neubertphillip-commits/fx991/hardware/tastatur_nummern.jpg

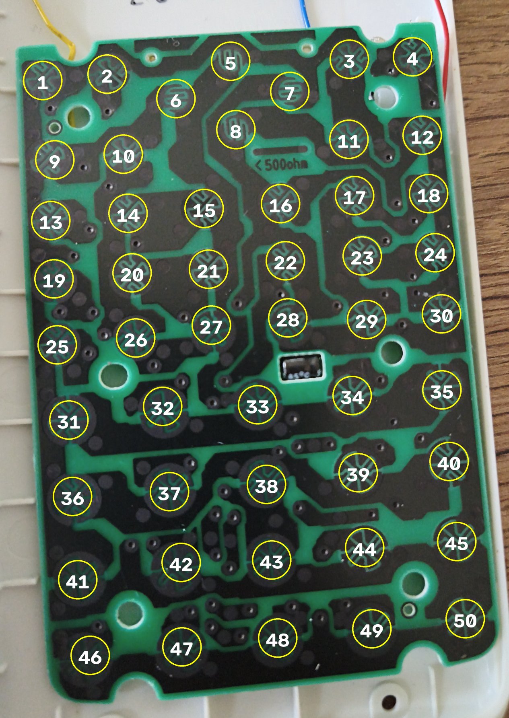
hardware/tastatur_nummern.jpg
