neubertphillip-commits/fx991/hardware/loetpunkte.jpg

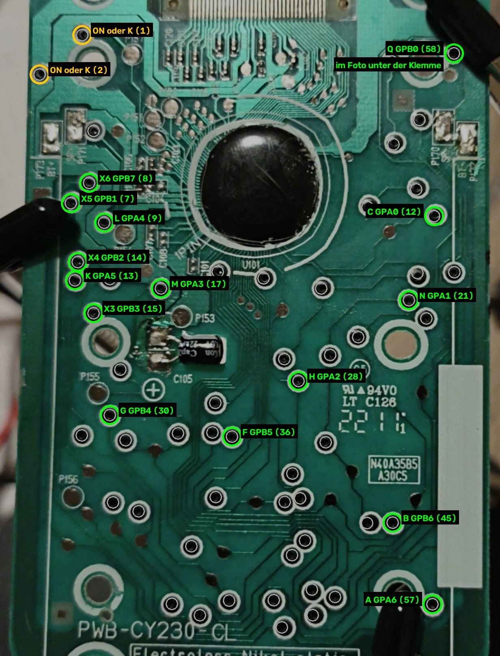
hardware/loetpunkte.jpg
