neubertphillip-commits/fx991/hardware/pcb/vorlage.pdf

1

2

3

4

5

6 | 7

8

9 | 10 | 11 | 12
13 | 14 | 15 | 16 | 17 | 18
19 | 20 | 21 | 22 | 23 | 24
25 | 26 | 27 | 28 | 29 | 30
31 | 32 | 33 | 34 | 35
36 | 37 | 38 | 39 | 40
41 | 42 | 43 | 44 | 45
46 | 47 | 48 | 49 | 50

50 mm - nachmessen! Drucken mit 100 % / tatsaechlicher Groesse

10 x 10 mm

# Casio-Deck Tastaturplatine - Papiertest (Entwurf 1)

Tastenseite von vorn. Blau: gemessen, rot gestrichelt: geschaetzt (im Foto im Schatten). Genauigkeit ca. 0,5-1 mm.

Loecher bewusst vergroessert (Spiel fuer die Zapfen, Platine wird festgeklebt). Wichtig ist nur: Tasten zueinander. Test: Matte auflegen, so schieben, dass die Noppen mittig sitzen. Abweichungen notieren (z. B. '46: 1 mm rechts').
