neubertphillip-commits/fx991/hardware/gegenmessung.md

# Gegenmessung: gehoeren Leitungen noch zusammen?

Zwei Leitungen koennen nur eine sein, wenn dadurch keine zwei Tasten dieselben zwei Leitungen
bekaemen (Beispiel: F und G nicht, sonst waeren 4 (C-F) und 7 (C-G) gleich). Nach dieser Regel
bleiben nur vier Paare, alle mit K.

2k-Bereich. **Nur kleine Werte (~0.05-0.60) zaehlen**, hohe Werte sind Umwege ueber den Casio-Chip.

| Messung | Kontakte | Ergebnis |
|---|---|---|
| K ↔ B | 18 (K-Haelfte) ↔ 42 (B-Haelfte) | getrennt |
| K ↔ F | 18 (K-Haelfte) ↔ 37 (F-Haelfte) | getrennt |
| K ↔ G | 18 (K-Haelfte) ↔ 32 (G-Haelfte) | getrennt |
| K ↔ Q | 18 (K-Haelfte) ↔ 5 (Q-Haelfte) | getrennt |
| 4 ↔ Q | 4 (EB-Haelfte, nicht K) ↔ 5 (Q-Haelfte) | getrennt: 4 hat eine eigene Leitung |

Gemessen: A und B mit keiner anderen Leitung verbunden. F-G gemessen, kann aber nicht sein
(siehe oben): bei 32 und 37 die N-Haelften getroffen (beide an N).
