neubertphillip-commits/fx991/hardware/pcb/vorlage.png

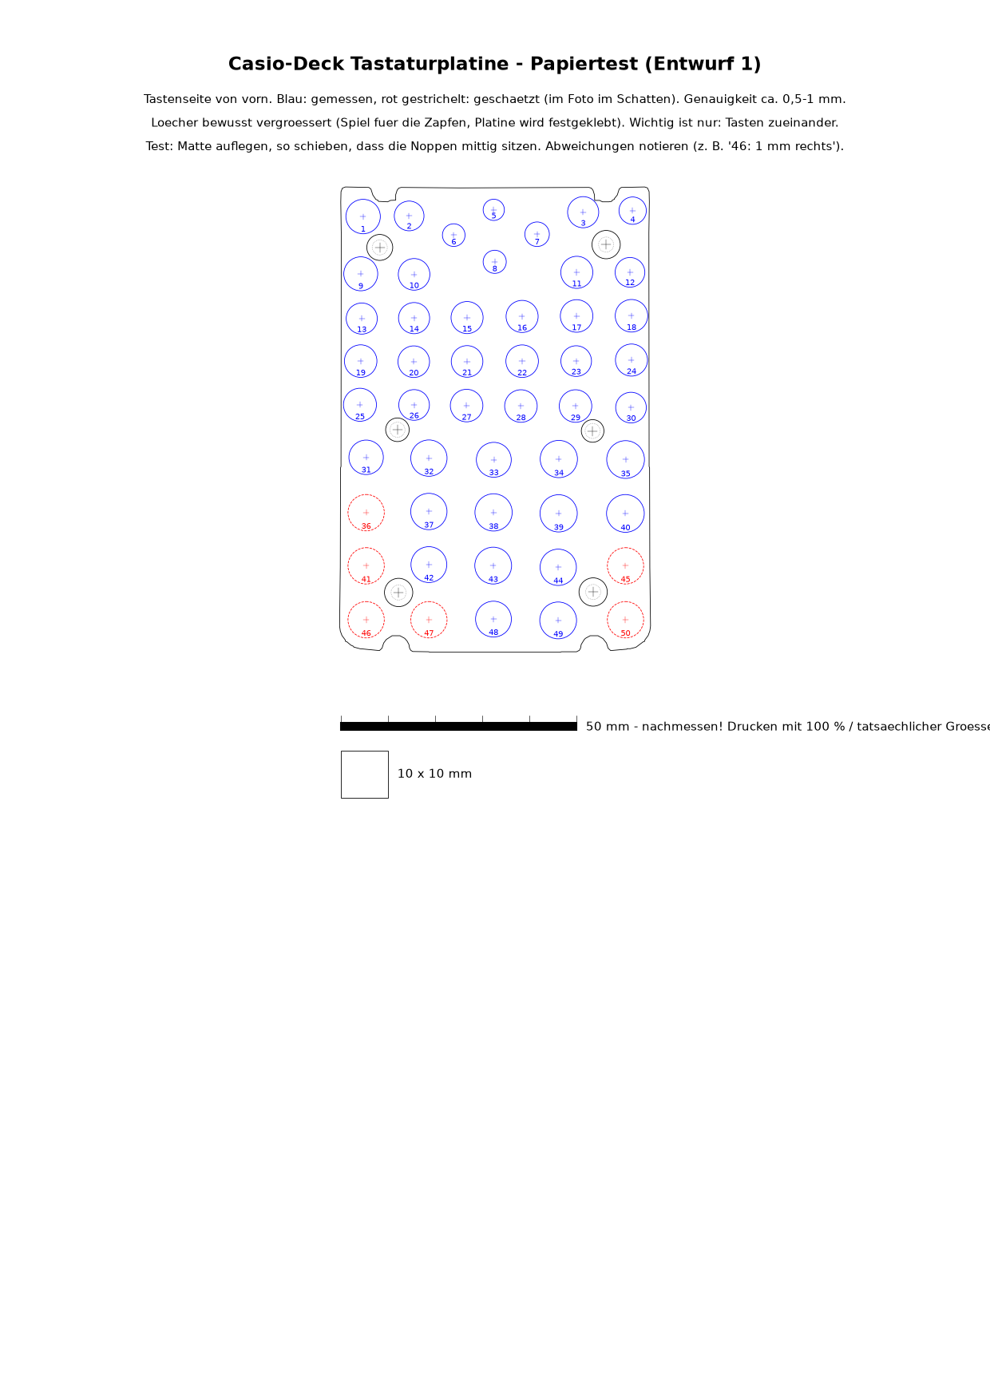
hardware/pcb/vorlage.png
