neubertphillip-commits/fx991/hardware/pcb/vorschau.png

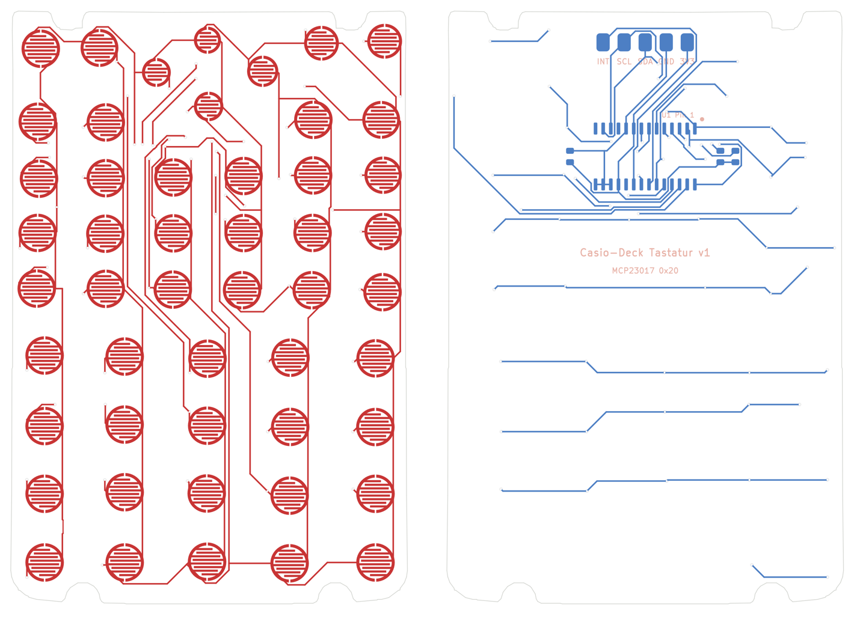
hardware/pcb/vorschau.png
