neubertphillip-commits/fx991/hardware/rueckseite_punkte.jpg

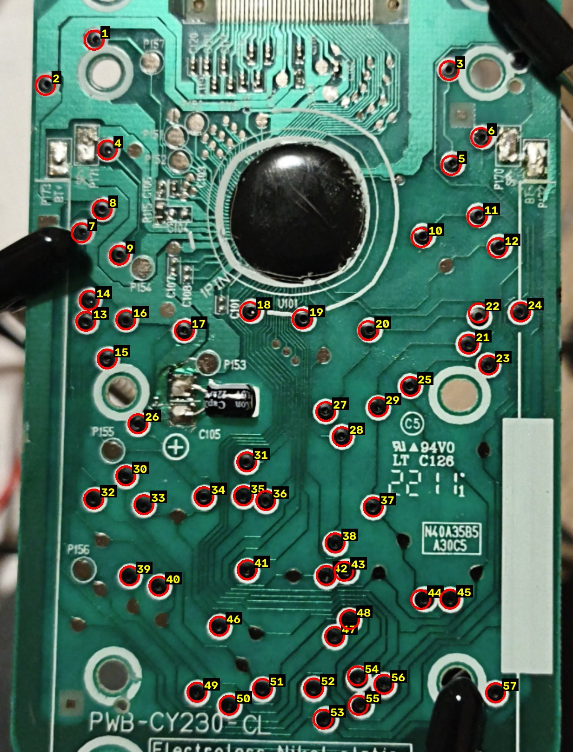
hardware/rueckseite_punkte.jpg
