neubertphillip-commits/fx991/(list of files, drawings)

Other design files:
hardware/pcb/tastatur.dsn
