neubertphillip-commits/fx991/hardware/pcb/tastatur.kicad_pcb

## KiCad design hardware/pcb/tastatur.kicad_pcb (2026-09-30)

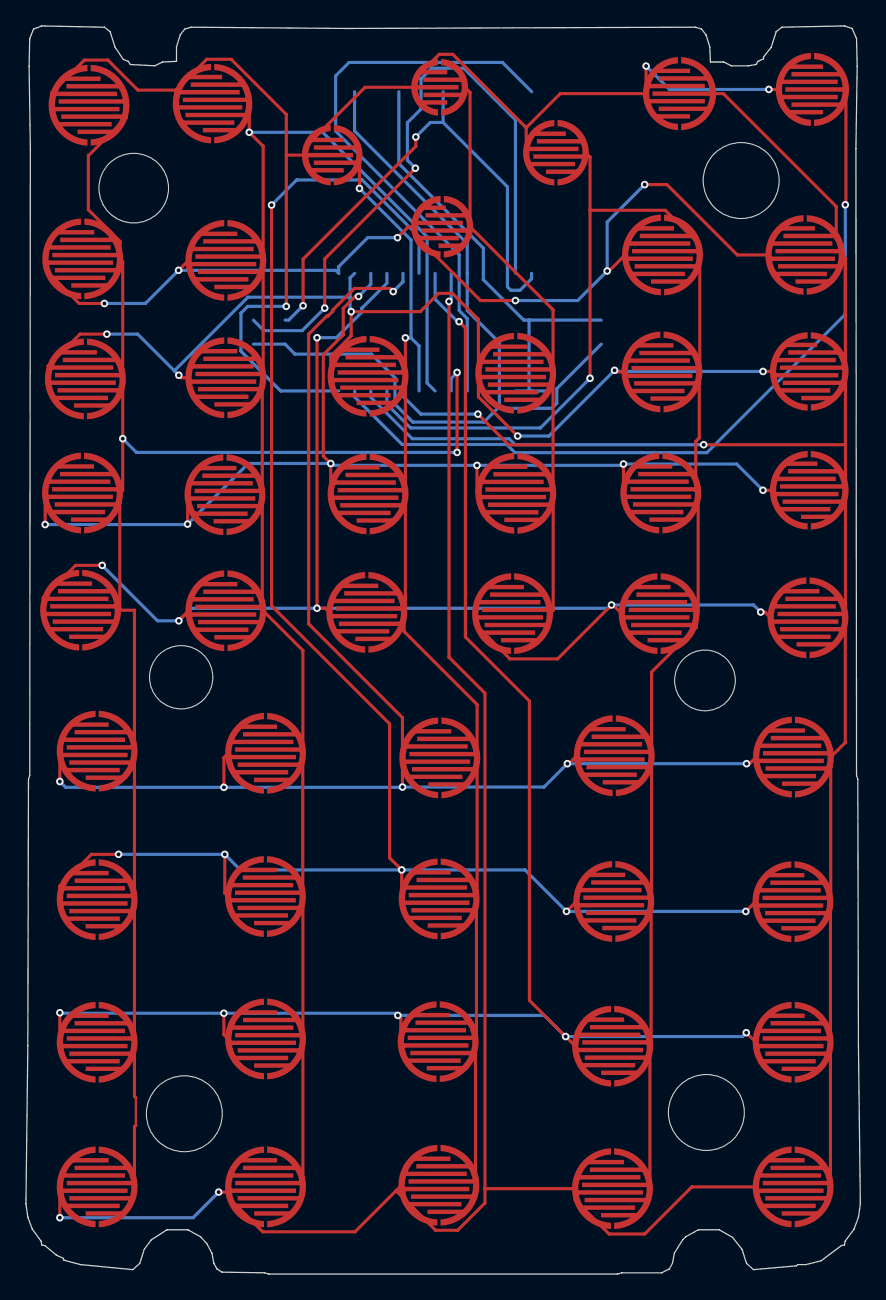
[picture p6: board tastatur.kicad_pcb from above]

Board: 2 copper layers, 65.9 x 98.6 mm, 61 parts (0 on the bottom side), 21 nets.

Parts:
C1: 100nF
H1, H2, H3, H4, H5, H6: (no value)
J1: XIAO
K1, K2, K3, K4, K5, K6, K7, K8, K9, K10, K11, K12, K13, K14, K15, K16, K17, K18, K19, K20, K21, K22, K23, K24, K25, K26, K27, K28, K29, K30, K31, K32, K33, K34, K35, K36, K37, K38, K39, K40, K41, K42, K43, K44, K45, K46, K47, K48, K49, K50: Taste
R1, R2: 4.7k
U1: MCP23017-E/SO

Connections:
3V3: C1.1, J1.1, R1.1, R2.1, U1.9, U1.18
C0: K1.2, K9.2, K13.2, K19.2, K25.2, K31.2, K36.2, K41.2, K46.2, U1.21
C1: K2.2, K10.2, K14.2, K20.2, K26.2, K32.2, K37.2, K42.2, K47.2, U1.22
C2: K6.2, K15.2, K21.2, K27.2, K33.2, K38.2, K43.2, K48.2, U1.23
C3: K5.2, K8.2, K16.2, K22.2, K28.2, U1.24
C4: K7.2, K11.2, K17.2, K23.2, K29.2, K34.2, K39.2, K44.2, K49.2, U1.25
C5: K3.2, K12.2, K18.2, K24.2, K30.2, K35.2, K40.2, K45.2, K50.2, U1.26
C6: K4.2, U1.27
GND: C1.2, J1.2, U1.10, U1.15, U1.16, U1.17
INT: J1.5, U1.20
R0: K1.1, K2.1, K3.1, K4.1, K5.1, K6.1, K7.1, U1.28
R1: K8.1, K9.1, K10.1, K11.1, K12.1, U1.1
R2: K13.1, K14.1, K15.1, K16.1, K17.1, K18.1, U1.2
R3: K19.1, K20.1, K21.1, K22.1, K23.1, K24.1, U1.3
R4: K25.1, K26.1, K27.1, K28.1, K29.1, K30.1, U1.4
R5: K31.1, K32.1, K33.1, K34.1, K35.1, U1.5
R6: K36.1, K37.1, K38.1, K39.1, K40.1, U1.6
R7: K41.1, K42.1, K43.1, K44.1, K45.1, U1.7
R8: K46.1, K47.1, K48.1, K49.1, K50.1, U1.8
SCL: J1.4, R2.2, U1.12
SDA: J1.3, R1.2, U1.13
