neubertphillip-commits/fx991/firmware/casio_deck/casio_deck.ino

// Casio-Deck: XIAO ESP32S3 im Gehaeuse eines Casio fx-991.
// Die eigentliche Logik steckt in app.cpp; siehe firmware/README.md.

#include "app.h"

void setup() { app::begin(); }

void loop() { app::loop(); }
