neubertphillip-commits/fx991/(commit log)

2026-09-25 Bridge fuer Termux und Projektkontext
    Claude-Session: https://claude.ai/code/session_01WamsmbzaYvenZsV1E42j99
2026-09-25 Firmware-Grundgeruest fuer den XIAO ESP32S3
    Zustandsautomat (Rechner / Terminal / Kamera), WLAN mit automatischer
    Abschaltung im Rechnermodus, WebSocket-Client fuer das Bridge-Protokoll
    und MCP23017-Tastaturscan mit Entprellung und INTA-Wakeup. Solange das
    LT7680-Panel fehlt, wird der Bildschirm auf dem seriellen Monitor
    ausgegeben; Eingaben gehen dort ebenfalls. Unbelegte Tasten melden
    Zeile/Spalte und MCP-Pin, um die Matrix auszumessen.
    Kompiliert mit arduino-esp32 3.3.12 (XIAO_ESP32S3, OPI-PSRAM);
    Host-Tests fuer Rechner und Textpuffer unter firmware/hosttest.
    Claude-Session: https://claude.ai/code/session_018xurYUYAMjcQd5yu9g7cvN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
2026-09-25 ALPHA-Texteingabe, Kamera und PC-Simulator
    - Mehrfachtippen wie am alten Handy (inkl. Umlaute/ss), ALPHA je Modus,
    im Terminal und Kameramodus standardmaessig an
    - Kamera (OV3660, XIAO-Sense-Pins): an nur im Kameramodus, EXE schickt
    JPEG als Binaer-Frame und die Eingabe als Frage an die Bridge
    - PC-Simulator (firmware/sim): dieselbe Firmware-Logik als Terminal-
    programm mit Arduino/WiFi/WebSocket-Ersatz, spricht mit der echten
    Bridge; zeichnet den 60x40-Screen als Vorlage fuers Panel-Layout
    - net::setBridge(), app::injectKey(), serieller Befehl ":key NAME"
    - Host-Tests fuer Mehrfachtippen
    Firmware kompiliert mit arduino-esp32 3.3.12; Simulator end-to-end
    gegen bridge.py mit Fake-cla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
2026-09-26 Spracheingabe ueber das Mikrofon der Sense-Platine
    - Firmware: PDM-Aufnahme (ESP_I2S) in eigenem Task in den PSRAM,
    max. 30 s, als WAV (16 kHz mono) per Binaer-Frame an die Bridge.
    SHIFT+ALPHA startet, EXE/ALPHA schickt, AC verwirft; Status "REC 3s".
    Erkannter Text landet in der Eingabezeile (VOICE_AUTO_SEND optional).
    - Bridge: erkennt WAV am RIFF/WAVE-Header, ruft den --stt-Befehl auf
    (z.B. whisper.cpp), filtert Markierungen wie [BLANK_AUDIO] und
    antwortet mit {"t":"text"}. Ohne --stt nur eine Fehlermeldung.
    - net::sendImage() -> sendBinary() (JPEG und WAV)
    - Simulator: --mic datei.wav, Taste v; testclient: /wav
    - Host-Tests fuer WAV-Header und Verstaerkung
    - Doku: whisper.cpp in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
2026-09-26 Ein/Aus per Tiefschlaf, Watchdog und Updates per WLAN
    Der eingebaute Rechner hat keinen Schalter und keinen erreichbaren USB-Port.
    - power: SHIFT+AC oder 10 min ohne Eingabe -> Tiefschlaf, Wecken per Taste
    ueber MCP23017-INTA (ext0 auf D0). Wecktaste zaehlt nicht als Eingabe;
    Modus, Ans, DEG/RAD bleiben im RTC-RAM. Watchdog 30 s.
    - ota: ArduinoOTA mit Passwort, solange WLAN steht; pio-Env xiao_esp32s3_ota.
    Neue Firmware wird erst bestaetigt, wenn sie wieder Updates annehmen kann,
    sonst Rollback durch den Bootloader. Unbestaetigt kein Ausschalten.
    - credentials.h teilt secrets.h zwischen net und ota
    - Simulator: SHIFT+AC zeigt "aus", Taste weckt
    - Doku: OTA, Ein/Aus; CLAUDE.md: Safe-C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
2026-09-26 CLAUDE.md: Reichelt-Bestellung, LT7680 mit 3,3 V, Ladepad statt Mappen-Elektronik
    Claude-Session: https://claude.ai/code/session_018xurYUYAMjcQd5yu9g7cvN
2026-09-26 WLAN nur bei Bedarf statt dauerhaft im Terminalmodus
    - Postausgang fuer Frage, Foto, Sprachaufnahme und neue Sitzung: WLAN geht
    beim Senden an, die Anfrage geht raus, sobald die Bridge verbunden ist;
    nach 45 s ohne Verbindung wird sie verworfen
    - WLAN geht in allen Modi 30 s nach der letzten Antwort aus (WIFI_LINGER_MS)
    - Foto wird sofort aufgenommen und als Kopie gehalten; bei Sprache wird
    schon waehrend der Aufnahme verbunden
    - Schnelles Wiederverbinden: Kanal und BSSID im RTC-RAM, Fallback auf
    normale Suche nach 3 s
    - SHIFT+MODE im Terminal/Kamera bzw. ":ota": WLAN 5 min an fuer Updates
    - Simulator: WiFi-Ersatz kennt BSSID/Kanal; im Simulator getestet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
2026-09-26 Strom sparen: WLAN-Wartemodus, 80 MHz, Leichtschlaf im Leerlauf
    - WLAN geht 3 s nach der Antwort aus statt nach 30 s
    - Beim Warten auf Claude Modem-Sleep mit Listen-Interval 10 (~1 s) statt
    Trennen und Pollen; beim Senden und 2 s danach voller Funk
    - CPU mit 80 MHz
    - Leichtschlaf im Leerlauf (WLAN/Kamera/Mikro aus), Wecken per INTA oder
    Timer; nicht bei angestecktem USB
    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
2026-09-27 Datei-Viewer: Texte, PDFs und Bilder vom Handy offline lesen
    - Neuer Modus DATEIEN: Liste, Textansicht mit eigenem Umbruch (nur
    Zeilenanfaenge im RAM), Bildinfo bis zum LT7680-Treiber (display::showJpeg)
    - Speicher im LittleFS (1,5 MB), im Simulator ein Ordner (--files)
    - Abgleich mit dem Ordner der Bridge (--files) per CRC-32: nur neue und
    geaenderte Dateien, Geloeschtes verschwindet auch auf dem Rechner
    - Bridge bereitet auf: Text -> UTF-8, PDF -> Text (pdftotext), Bilder ->
    JPEG 480x640 (Pillow); Namen fuer das Dateisystem vereinfacht
    - Tests: TextLayout, CRC-32, JPEG-Header (hosttest), library.py (unittest)
    Claude-Session: ht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
2026-09-27 CLAUDE.md: Plan fuer die Android-App (Kern + Module, Verbindung, Akku)
    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
2026-09-29 Nummerierte Karte der Tastenkontakte zum Ausmessen
    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
2026-09-29 Messprotokoll der Tastaturmatrix (Vorderseite, 33 von 50 Tasten)
    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
2026-09-29 Messprotokoll: Leitungen R und S
    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
2026-09-29 Messprotokoll: Zeilen 13-18, 19-24 und oben (S+U) bestaetigt
    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
2026-09-29 Liste zum Gegenmessen der Leitungen
    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
2026-09-29 Tastatur nach Messung: 16 Leitungen, Scan je Treiber plus A, Keymap mit 50 Kontakten
    - config.h: Leitungen C N H M L K A ON (GPA0-7) und Q X5 X4 X3 G F B X6 (GPB0-7)
    - keypad.cpp: Treiber einzeln LOW, dann A allein (fuer . und x10^x);
    keine Taste zwischen zwei Treibern, also kein Kurzschluss
    - keymap.cpp: Tabelle Kontakt -> Leitungen -> Taste (Zahlenblock und Pfeile belegt)
    - hosttest: prueft Eindeutigkeit, Erkennbarkeit und Kurzschlussfreiheit
    - README: Belegung MCP23017 mit SO-28-Pins
    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
2026-09-29 Modell korrigiert: fx-991DE X (ClassWiz EX); Displaymasse
    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
    [config.h, keypad.h]
2026-09-29 CLAUDE.md: Displayfenster gemessen (62 x 25 mm)
    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
2026-09-29 CLAUDE.md: Displaylage hinter Display- und Solarfenster berechnet
    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
2026-09-29 Loetpunkte: silberner Ring der Durchkontaktierung nimmt Zinn
    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
2026-09-29 Loetpunkte: Hinweis Nickel anrauen und Flussmittel
    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
2026-09-29 Tastaturplatine: Geometrie aus Fotos und Druckvorlage fuer den Papiertest
    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
2026-09-29 Tastaturplatine: Loecher vergroessert (Spiel fuer die Zapfen, Platine wird angeklebt)
    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
2026-09-29 Tastaturplatine Entwurf 1: KiCad-Generator, verdrahtet (Freerouting), Fertigungsdaten
    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
    [bom_jlc.csv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]
2026-09-30 CLAUDE.md: Innentiefe und Dicke LT7680-Board
    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
2026-09-30 CLAUDE.md: Tiefe hinter der Tastaturplatine
    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
2026-09-30 CLAUDE.md: Version 1 mit Casio-Platine und Silber-Leitkleber
    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
2026-09-30 Tastaturplatine: Pruefung Variante C (Sense-Funktionen auf der Platine)
    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
